JustAGlitchFL/CTRL/README.md

# CTRL
A split semi-compact keyboard with extra features

bom and pics soon(tm)
