JustAGlitchFL/CTRL/ALT (Right)/cheyao macropad main PCB-third_party_neopixel.petty/SK6812MINI-E.step

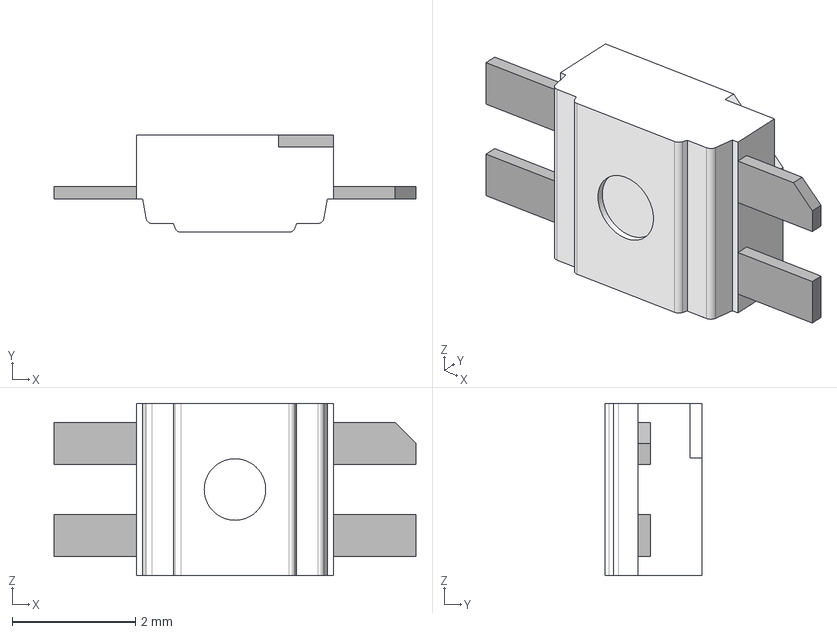
[picture p20: CAD file, 2025-05-31]
ALT (Right)/cheyao macropad main PCB-third_party_neopixel.petty/SK6812MINI-E.step
5.88 x 1.58 x 2.80 mm
