JustAGlitchFL/CTRL/ALT (Right)/LIB_MCP3008-I_SL/MCP3008-I_SL/3D/MCP3008-I_SL.stp

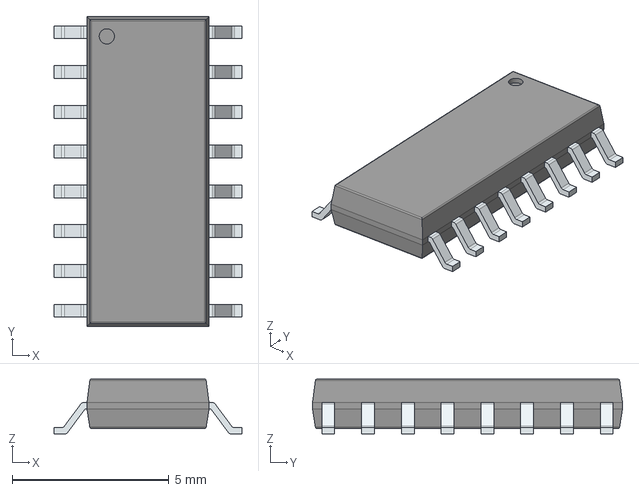
[picture p21: CAD file, 2025-05-31]
ALT (Right)/LIB_MCP3008-I_SL/MCP3008-I_SL/3D/MCP3008-I_SL.stp
6.00 x 9.90 x 1.75 mm
PinsArrayLR
