JustAGlitchFL/CTRL/ALT (Right)/RKJXT1F42001/3D/RKJXT1F42001.stp

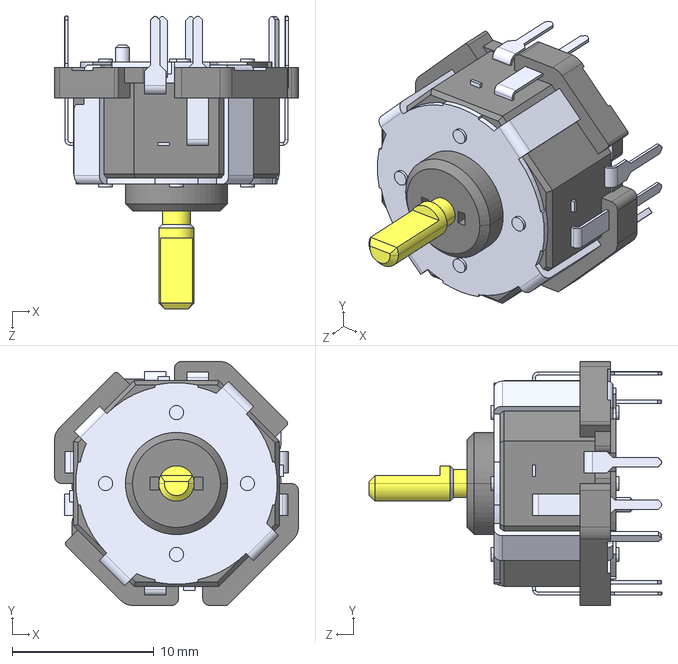
[picture p22: CAD file, 2025-05-31]
ALT (Right)/RKJXT1F42001/3D/RKJXT1F42001.stp
17.2 x 17.2 x 20.6 mm
