JustAGlitchFL/CTRL/CTRL (Left)/CTRL/hackboard-F_Courtyard.dxf

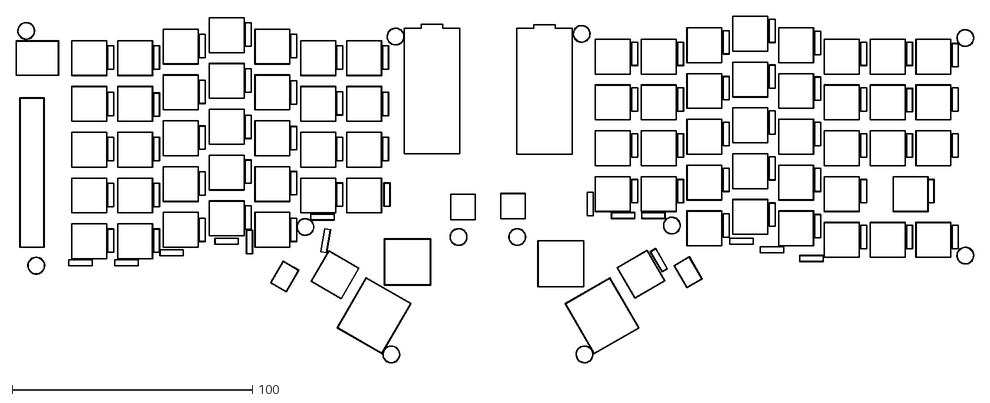
[picture p23: CAD file, 2025-05-31]
CTRL (Left)/CTRL/hackboard-F_Courtyard.dxf
398.1 x 144.1
