JustAGlitchFL/CTRL/HackBoard (Both)/hackboard/hackboard-Edge_Cuts.dxf

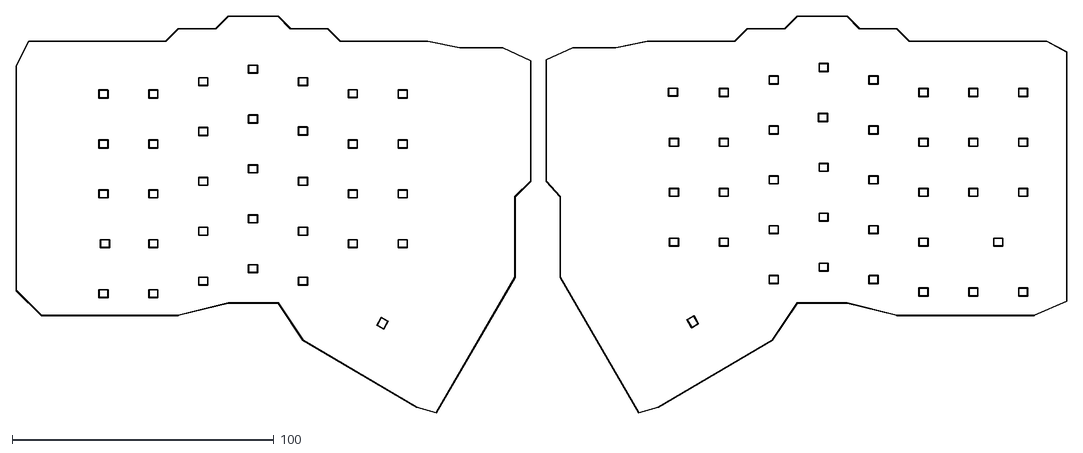
[picture p24: CAD file, 2025-05-31]
HackBoard (Both)/hackboard/hackboard-Edge_Cuts.dxf
401.3 x 151.6
