JustAGlitchFL/CTRL/HackBoard (Both)/hackboard/hackboard-User_Eco1.dxf

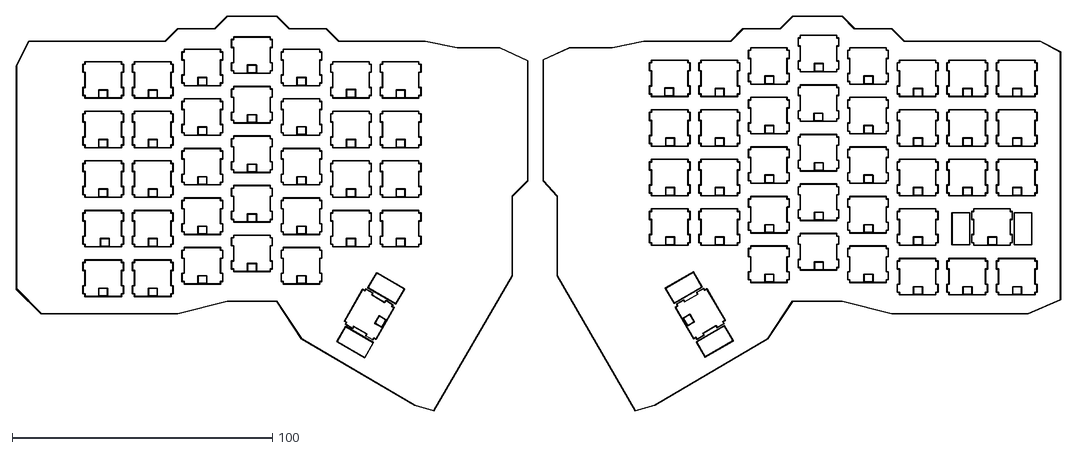
[picture p25: CAD file, 2025-05-31]
HackBoard (Both)/hackboard/hackboard-User_Eco1.dxf
401.3 x 151.6
