JustAGlitchFL/CTRL/HackBoard (Both)/hackboard/hackboard-User_1.dxf

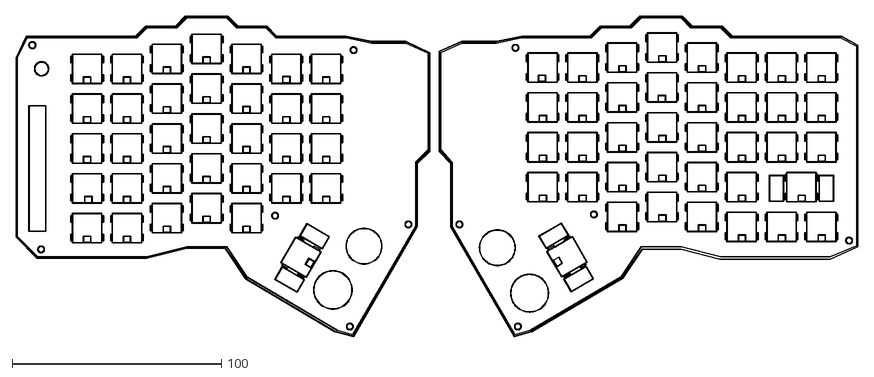
[picture p26: CAD file, 2025-05-31]
HackBoard (Both)/hackboard/hackboard-User_1.dxf
402.5 x 153.1
