JustAGlitchFL/CTRL/ALT (Right)/RS45111A900F/3D/RS45111A900F.stp

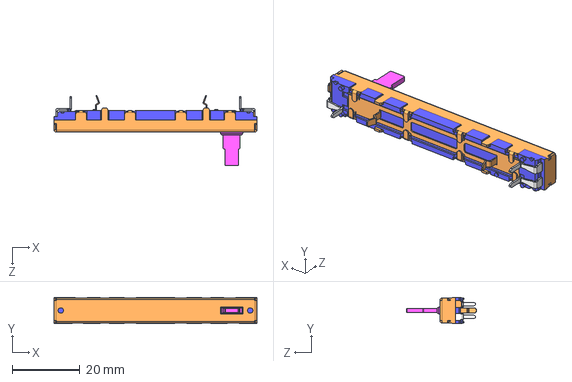
[picture p27: CAD file, 2025-05-31]
ALT (Right)/RS45111A900F/3D/RS45111A900F.stp
60.0 x 7.80 x 20.8 mm
