JustAGlitchFL/CTRL/(list of files, cad)

Other CAD files:
ALT (Right)/ALT/alt.step
ALT (Right)/LIB_MCP3008-I_SL/MCP3008-I_SL/Allegro/soic127p600x175-16n.psm
ALT (Right)/LIB_MCP3008-I_SL/MCP3008-I_SL/DEHDL/mcp3008_i_sl/chips/chips.prt
ALT (Right)/LIB_RKJXV122400R/RKJXV122400R/Allegro/rkjxv122400r.psm
ALT (Right)/LIB_RKJXV122400R/RKJXV122400R/DEHDL/rkjxv122400r/chips/chips.prt
ALT (Right)/RKJXT1F42001/Allegro/rkjxt1f42001.psm
ALT (Right)/RKJXT1F42001/DEHDL/rkjxt1f42001/chips/chips.prt
ALT (Right)/RS45111A900F/Allegro/rs45111a900f.psm
ALT (Right)/RS45111A900F/DEHDL/rs45111a900f/chips/chips.prt
CTRL (Left)/LIB_MCP3008-I_SL/MCP3008-I_SL/Allegro/soic127p600x175-16n.psm
CTRL (Left)/LIB_MCP3008-I_SL/MCP3008-I_SL/DEHDL/mcp3008_i_sl/chips/chips.prt
CTRL (Left)/LIB_RKJXV122400R/RKJXV122400R/Allegro/rkjxv122400r.psm
CTRL (Left)/LIB_RKJXV122400R/RKJXV122400R/DEHDL/rkjxv122400r/chips/chips.prt
CTRL (Left)/RKJXT1F42001/Allegro/rkjxt1f42001.psm
CTRL (Left)/RKJXT1F42001/DEHDL/rkjxt1f42001/chips/chips.prt
CTRL (Left)/RS45111A900F/Allegro/rs45111a900f.psm
CTRL (Left)/RS45111A900F/DEHDL/rs45111a900f/chips/chips.prt
HackBoard (Both)/LIB_MCP3008-I_SL/MCP3008-I_SL/Allegro/soic127p600x175-16n.psm
HackBoard (Both)/LIB_MCP3008-I_SL/MCP3008-I_SL/DEHDL/mcp3008_i_sl/chips/chips.prt
HackBoard (Both)/LIB_RKJXV122400R/RKJXV122400R/Allegro/rkjxv122400r.psm
HackBoard (Both)/LIB_RKJXV122400R/RKJXV122400R/DEHDL/rkjxv122400r/chips/chips.prt
HackBoard (Both)/RKJXT1F42001/Allegro/rkjxt1f42001.psm
HackBoard (Both)/RKJXT1F42001/DEHDL/rkjxt1f42001/chips/chips.prt
HackBoard (Both)/RS45111A900F/Allegro/rs45111a900f.psm
HackBoard (Both)/RS45111A900F/DEHDL/rs45111a900f/chips/chips.prt
