JustAGlitchFL/CTRL/CTRL (Left)/CTRL/CTRL.kicad_pcb

## KiCad design CTRL (Left)/CTRL/CTRL.kicad_pcb (2025-05-31)

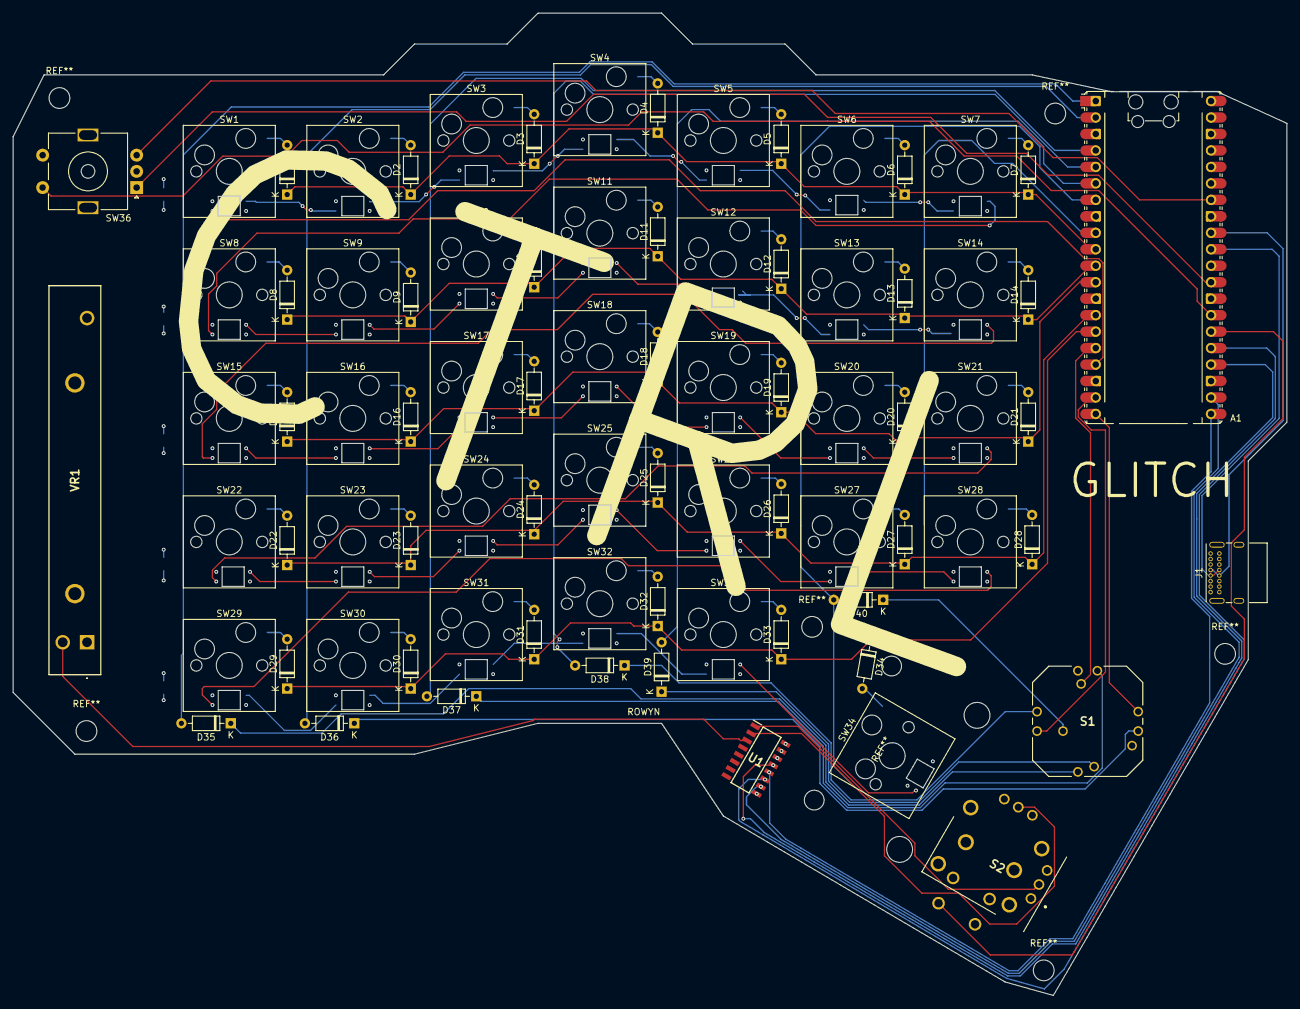
[picture p32: board CTRL.kicad_pcb from above]

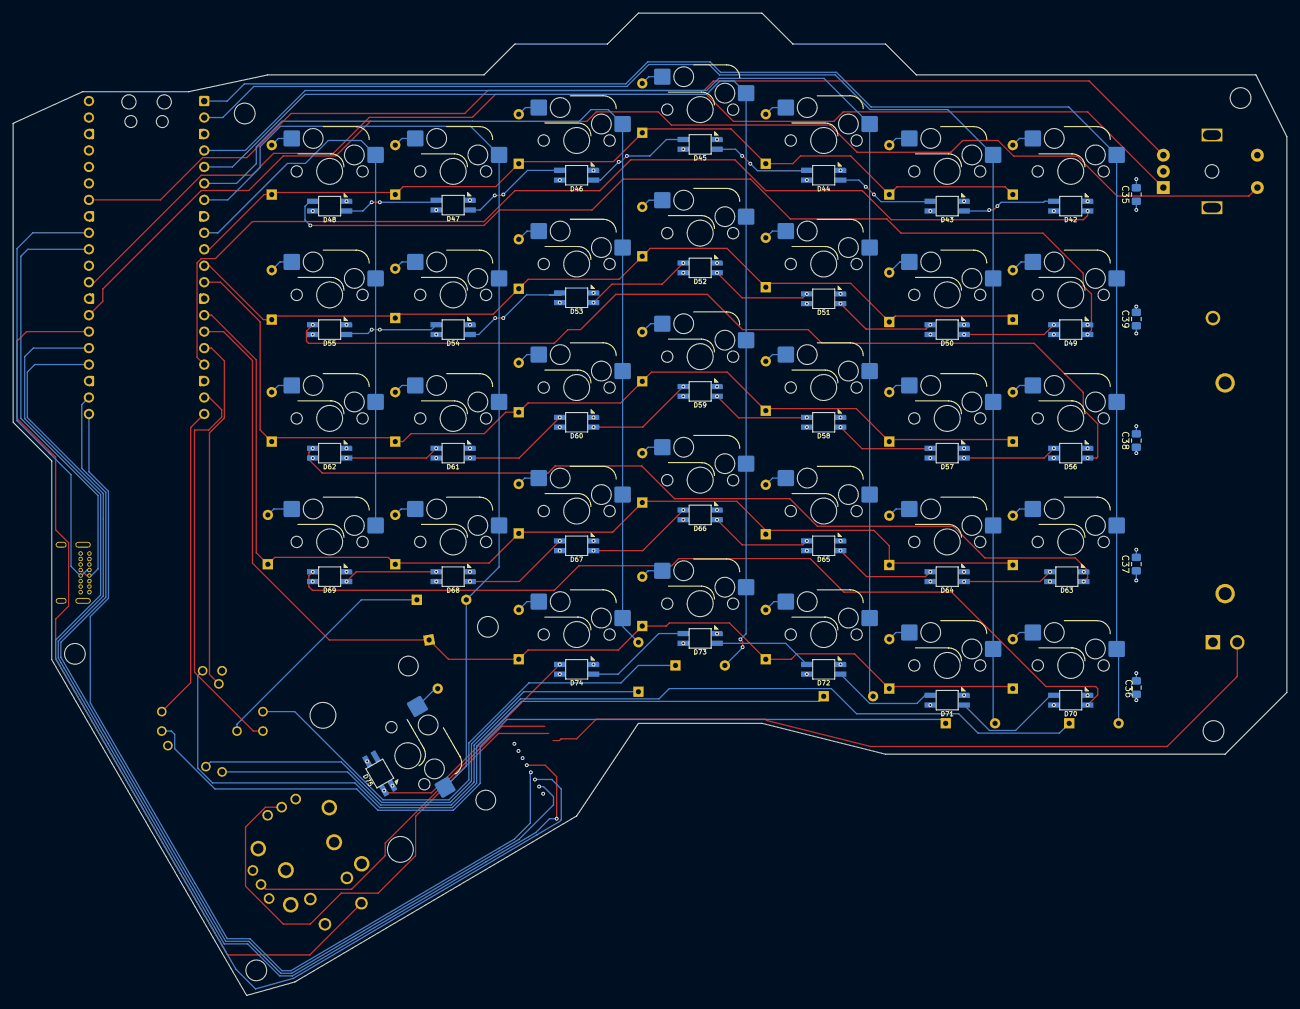
[picture p33: board CTRL.kicad_pcb from below]

Board: 4 copper layers, 196.5 x 151.5 mm, 120 parts (39 on the bottom side), 102 nets.

Parts:
A1: RaspberryPi_Pico; RaspberryPi_Pico_Common_Unspecified
C35, C36, C37, C38, C39: C; C_0805_2012Metric_Pad1.18x1.45mm_HandSolder
D1, D2, D3, D4, D5, D6, D7, D8, D9, D10, D11, D12, D13, D14, D15, D16, D17, D18, D19, D20, D21, D22, D23, D24, D25, D26, D27, D28, D29, D30, D31, D32, D33, D34, D35, D36, D37, D38, D39, D40: D; D_DO-35_SOD27_P7.62mm_Horizontal
D42, D43, D44, D45, D46, D47, D48, D49, D50, D51, D52, D53, D54, D55, D56, D57, D58, D59, D60, D61, D62, D63, D64, D65, D66, D67, D68, D69, D70, D71, D72, D73, D74, D75: SK6812MINI; SK6812MINI-E
J1: USB_C_Receptacle_USB2.0_14P; USB_C_Receptacle_GCT_USB4085
S1: RKJXT1F42001
S2: RKJXV122400R
SW1, SW2, SW3, SW4, SW5, SW6, SW7, SW8, SW9, SW10, SW11, SW12, SW13, SW14, SW15, SW16, SW17, SW18, SW19, SW20, SW21, SW22, SW23, SW24, SW25, SW26, SW27, SW28, SW29, SW30, SW31, SW32, SW33: SW_Push; Hotswap_MX_1.00u
SW34: SPACE; Hotswap_MX_2.00u
SW36: RotaryEncoder_Switch; RotaryEncoder_Alps_EC11E-Switch_Vertical_H20mm_MountingHoles
U1: MCP3008; SOIC127P600X175-16N
VR1: RS45111A900F

Connections:
+3V3: A1.36 (3V3), A1.39 (VSYS)
+5V: A1.40 (VBUS), C35.1, C36.1, C37.1, C38.1, C39.1, D42.4 (VDD), D43.4 (VDD), D44.4 (VDD), D45.4 (VDD), D46.4 (VDD), D47.4 (VDD), D48.4 (VDD), D49.4 (VDD), D50.4 (VDD), D51.4 (VDD), D52.4 (VDD), D53.4 (VDD), D54.4 (VDD), D55.4 (VDD), D56.4 (VDD), D57.4 (VDD), D58.4 (VDD), D59.4 (VDD), D60.4 (VDD), D61.4 (VDD), D62.4 (VDD), D63.4 (VDD), D64.4 (VDD), D65.4 (VDD), D66.4 (VDD), D67.4 (VDD), D68.4 (VDD), D69.4 (VDD), D70.4 (VDD), D71.4 (VDD), D72.4 (VDD), D73.4 (VDD), D74.4 (VDD), D75.4 (VDD), J1.A4 (VBUS), J1.A9 (VBUS), J1.B4 (VBUS), J1.B9 (VBUS), S2.A11, S2.B11, U1.15 (Vref), U1.16 (Vdd), VR1.1 (CCW)
COL0: A1.1 (GPIO0), D35.2 (A), SW1.1, SW8.1, SW15.1, SW22.1, SW29.1
COL1: A1.2 (GPIO1), D36.2 (A), SW2.1, SW9.1, SW16.1, SW23.1, SW30.1
COL2: A1.4 (GPIO2), D37.2 (A), SW3.1, SW10.1, SW17.1, SW24.1, SW31.1
COL3: A1.5 (GPIO3), D38.2 (A), SW4.1, SW11.1, SW18.1, SW25.1, SW32.1
COL4: A1.6 (GPIO4), D39.2 (A), SW5.1, SW12.1, SW19.1, SW26.1, SW33.1
COL5: A1.7 (GPIO5), D40.2 (A), SW6.1, SW13.1, SW20.1, SW27.1, SW34.1
COL6: A1.9 (GPIO6), SW7.1, SW14.1, SW21.1, SW28.1
EC1A: A1.19 (GPIO14), S1.10 (ENCODER_A)
EC1B: A1.20 (GPIO15), S1.5 (ENCODER_B)
EC2A: A1.29 (GPIO22), SW36.A
EC2B: A1.34 (GPIO28_ADC2), SW36.B
ECROW: A1.16 (GPIO12), S1.7 (COM)
GND: A1.3 (GND), A1.8 (GND), A1.13 (GND), A1.18 (GND), A1.23 (GND), A1.28 (GND), A1.38 (GND), C35.2, C36.2, C37.2, C38.2, C39.2, D42.2 (VSS), D43.2 (VSS), D44.2 (VSS), D45.2 (VSS), D46.2 (VSS), D47.2 (VSS), D48.2 (VSS), D49.2 (VSS), D50.2 (VSS), D51.2 (VSS), D52.2 (VSS), D53.2 (VSS), D54.2 (VSS), D55.2 (VSS), D56.2 (VSS), D57.2 (VSS), D58.2 (VSS), D59.2 (VSS), D60.2 (VSS), D61.2 (VSS), D62.2 (VSS), D63.2 (VSS), D64.2 (VSS), D65.2 (VSS), D66.2 (VSS), D67.2 (VSS), D68.2 (VSS), D69.2 (VSS), D70.2 (VSS), D71.2 (VSS), D72.2 (VSS), D73.2 (VSS), D74.2 (VSS), D75.2 (VSS), J1.A1 (GND), J1.A12 (GND), J1.B1 (GND), J1.B12 (GND), J1.S1 (SHIELD), S1.3 (GND_TERMINAL), S1.8 (ENCODER_COM), S2.A13, S2.B13, S2.C1, SW36.C, SW36.S1, U1.9 (DGND), U1.14 (AGND), VR1.3 (CW)
unnamed: A1.21 (GPIO16), U1.12 (Dout)
unnamed: A1.22 (GPIO17), U1.10 (~CS/SHDN)
unnamed: A1.24 (GPIO18), U1.13 (CLK)
unnamed: A1.25 (GPIO19), U1.11 (Din)
unnamed: A1.31 (GPIO26_ADC0), J1.A6 (D+), J1.B6 (D+)
unnamed: A1.32 (GPIO27_ADC1), J1.A7 (D-), J1.B7 (D-)
unnamed: D1.2 (A), SW1.2
unnamed: D2.2 (A), SW2.2
unnamed: D3.2 (A), SW3.2
unnamed: D4.2 (A), SW4.2
unnamed: D5.2 (A), SW5.2
unnamed: D6.2 (A), SW6.2
unnamed: D7.2 (A), SW7.2
unnamed: D8.2 (A), SW8.2
unnamed: D9.2 (A), SW9.2
unnamed: D10.2 (A), SW10.2
unnamed: D11.2 (A), SW11.2
unnamed: D12.2 (A), SW12.2
unnamed: D13.2 (A), SW13.2
unnamed: D14.2 (A), SW14.2
unnamed: D15.2 (A), SW15.2
unnamed: D16.2 (A), SW16.2
unnamed: D17.2 (A), SW17.2
unnamed: D18.2 (A), SW18.2
unnamed: D19.2 (A), SW19.2
unnamed: D20.2 (A), SW20.2
unnamed: D21.2 (A), SW21.2
unnamed: D22.2 (A), SW22.2
unnamed: D23.2 (A), SW23.2
unnamed: D24.2 (A), SW24.2
unnamed: D25.2 (A), SW25.2
unnamed: D26.2 (A), SW26.2
unnamed: D27.2 (A), SW27.2
unnamed: D28.2 (A), SW28.2
unnamed: D29.2 (A), SW29.2
unnamed: D30.2 (A), SW30.2
unnamed: D31.2 (A), SW31.2
unnamed: D32.2 (A), SW32.2
unnamed: D33.2 (A), SW33.2
unnamed: D34.2 (A), SW34.2
unnamed: D35.1 (K), S1.1 (A)
unnamed: D36.1 (K), S1.4 (B)
unnamed: D37.1 (K), S1.6 (C)
unnamed: D38.1 (K), S1.9 (D_1)
unnamed: D39.1 (K), S1.2 (PUSH)
unnamed: D40.1 (K), S1.11 (D_2)
unnamed: D42.1 (DOUT), D43.3 (DIN)
unnamed: D43.1 (DOUT), D44.3 (DIN)
unnamed: D44.1 (DOUT), D45.3 (DIN)
unnamed: D45.1 (DOUT), D46.3 (DIN)
unnamed: D46.1 (DOUT), D47.3 (DIN)
unnamed: D47.1 (DOUT), D48.3 (DIN)
unnamed: D48.1 (DOUT), D49.3 (DIN)
unnamed: D49.1 (DOUT), D50.3 (DIN)
unnamed: D50.1 (DOUT), D51.3 (DIN)
unnamed: D51.1 (DOUT), D52.3 (DIN)
unnamed: D52.1 (DOUT), D53.3 (DIN)
unnamed: D55.1 (DOUT), D56.3 (DIN)
unnamed: D56.1 (DOUT), D57.3 (DIN)
unnamed: D57.1 (DOUT), D58.3 (DIN)
unnamed: D58.1 (DOUT), D59.3 (DIN)
unnamed: D59.1 (DOUT), D60.3 (DIN)
unnamed: D60.1 (DOUT), D61.3 (DIN)
unnamed: D61.1 (DOUT), D62.3 (DIN)
unnamed: D62.1 (DOUT), D63.3 (DIN)
unnamed: D63.1 (DOUT), D64.3 (DIN)
unnamed: D64.1 (DOUT), D65.3 (DIN)
unnamed: D65.1 (DOUT), D66.3 (DIN)
unnamed: D66.1 (DOUT), D67.3 (DIN)
unnamed: D67.1 (DOUT), D68.3 (DIN)
unnamed: D68.1 (DOUT), D69.3 (DIN)
unnamed: D69.1 (DOUT), D70.3 (DIN)
unnamed: D70.1 (DOUT), D71.3 (DIN)
unnamed: D71.1 (DOUT), D72.3 (DIN)
unnamed: D72.1 (DOUT), D73.3 (DIN)
unnamed: D73.1 (DOUT), D74.3 (DIN)
unnamed: S2.A12, U1.1 (CH0)
unnamed: S2.B12, U1.2 (CH1)
unnamed: U1.3 (CH2), VR1.2 (WIPER)
Push1: A1.26 (GPIO20), S2.B1
Push2: A1.27 (GPIO21), SW36.S2
RGB: A1.17 (GPIO13), D42.3 (DIN)
ROW0: A1.10 (GPIO7), D1.1 (K), D2.1 (K), D3.1 (K), D4.1 (K), D5.1 (K), D6.1 (K), D7.1 (K)
ROW1: A1.11 (GPIO8), D8.1 (K), D9.1 (K), D10.1 (K), D11.1 (K), D12.1 (K), D13.1 (K), D14.1 (K)
ROW2: A1.12 (GPIO9), D15.1 (K), D16.1 (K), D17.1 (K), D18.1 (K), D19.1 (K), D20.1 (K), D21.1 (K)
ROW3: A1.14 (GPIO10), D22.1 (K), D23.1 (K), D24.1 (K), D25.1 (K), D26.1 (K), D27.1 (K), D28.1 (K)
ROW4: A1.15 (GPIO11), D29.1 (K), D30.1 (K), D31.1 (K), D32.1 (K), D33.1 (K), D34.1 (K)
