JustAGlitchFL/CTRL/ALT (Right)/PS4_joystick_footprint-main/ps4.kicad_pcb

## KiCad design ALT (Right)/PS4_joystick_footprint-main/ps4.kicad_pcb (2025-05-31)

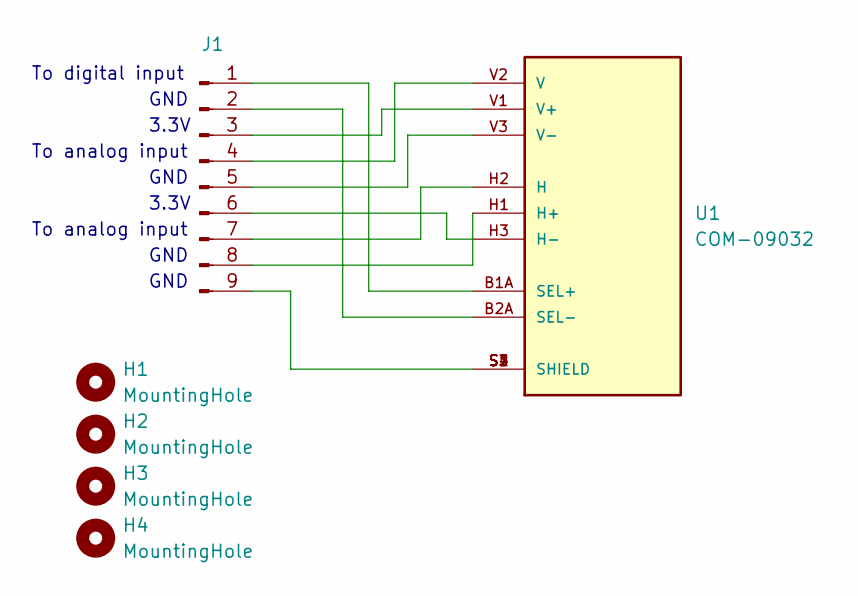
[picture p34: schematic ps4.kicad_sch]

Parts:
H1, H2, H3, H4: MountingHole; MountingHole_3.2mm_M3_DIN965
J1: Conn_01x05_Male; PinHeader_1x09_P2.54mm_Vertical
U1: COM-09032; XDCR_COM-09032; PARTREV N/A

Connections:
unnamed: J1.3, U1.V1 (V+)
unnamed: J1.4, U1.V2 (V)
unnamed: J1.5, U1.V3 (V-)
unnamed: J1.6, U1.H3 (H-)
unnamed: J1.7, U1.H2 (H)
unnamed: J1.8, U1.H1 (H+)
unnamed: J1.9, U1.S1 (SHIELD), U1.S2 (SHIELD), U1.S3 (SHIELD), U1.S4 (SHIELD)
unnamed: J1.1, U1.B1A (SEL+)
unnamed: J1.2, U1.B2A (SEL-)

Notes on the sheet:
GND
3.3V
To digital input
To analog input

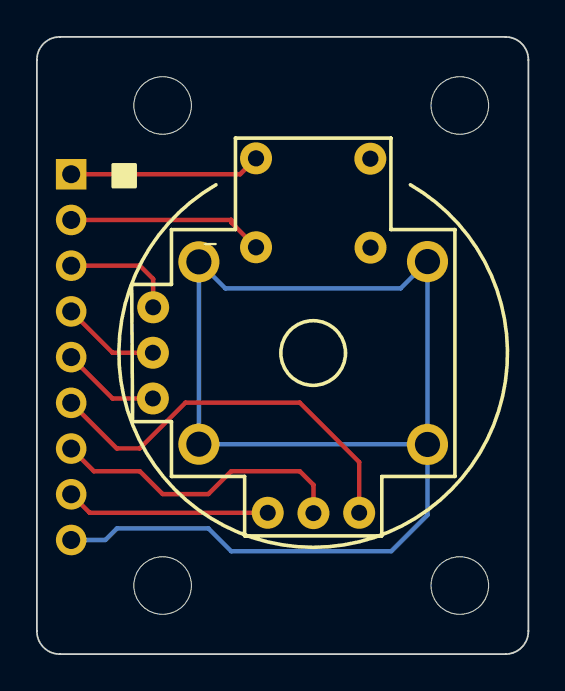
[picture p35: board ps4.kicad_pcb from above]

Board: 2 copper layers, 27.3 x 34.3 mm, 6 parts (1 on the bottom side), 9 nets.
